minisystem/860/backplane_cpu.png

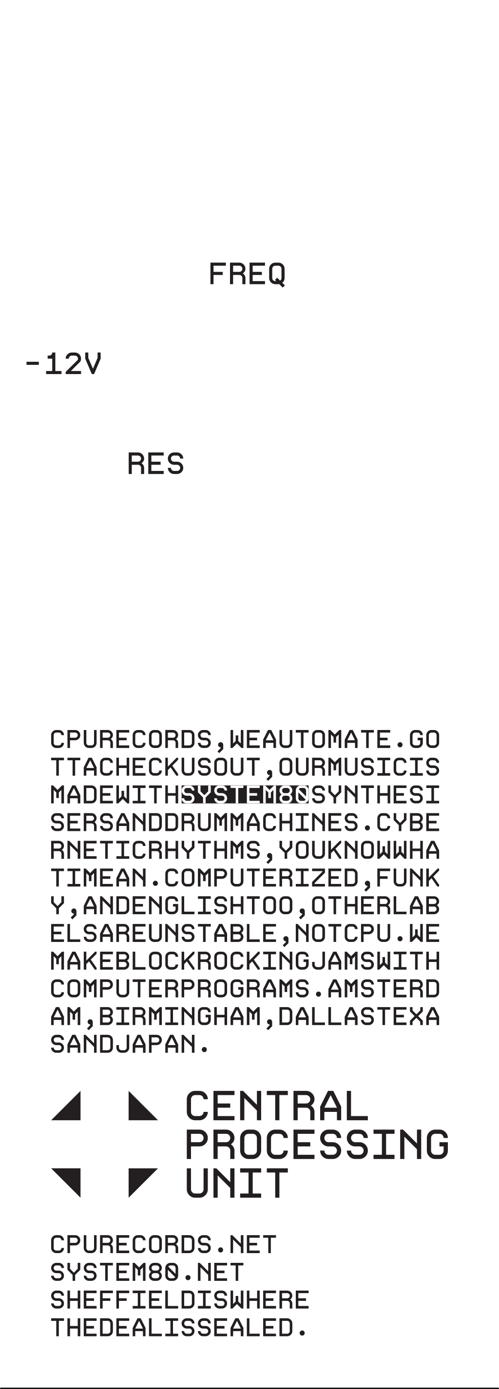
backplane_cpu.png
