minisystem/860/Gerbers/860-Eco1.User.dxf

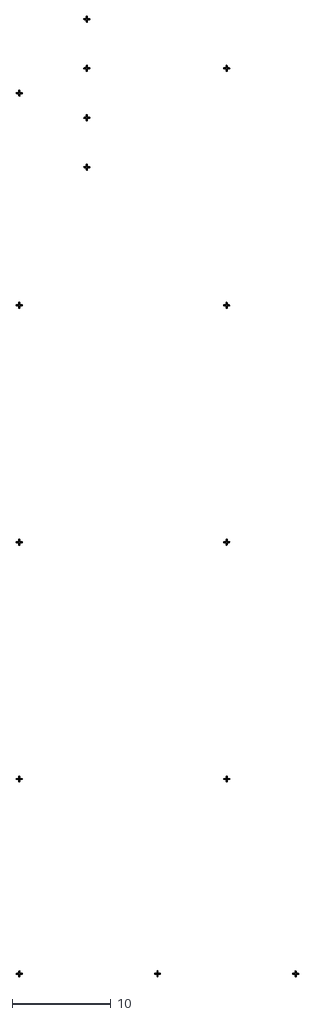
[picture p2: CAD file, 2019-05-11]
Gerbers/860-Eco1.User.dxf
28.6 x 97.3
