minisystem/860/Gerbers/860-F.SilkS.pdf

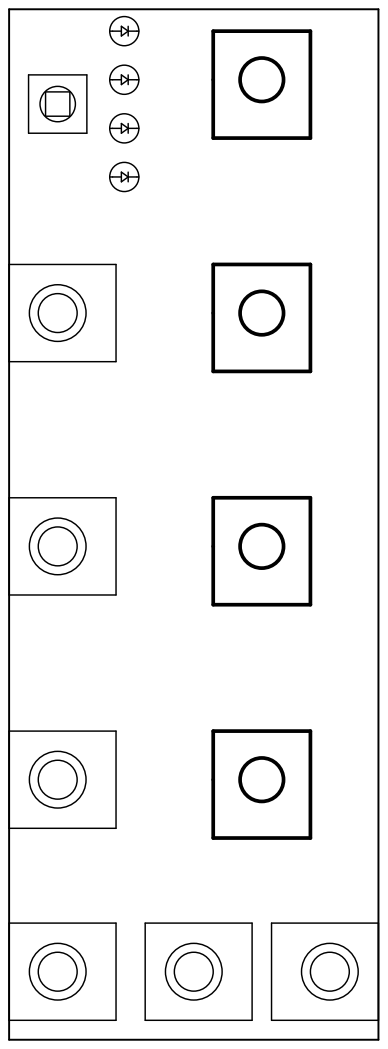
[picture p3: page 1]
