minisystem/860/Gerbers/860-Dwgs.User.pdf

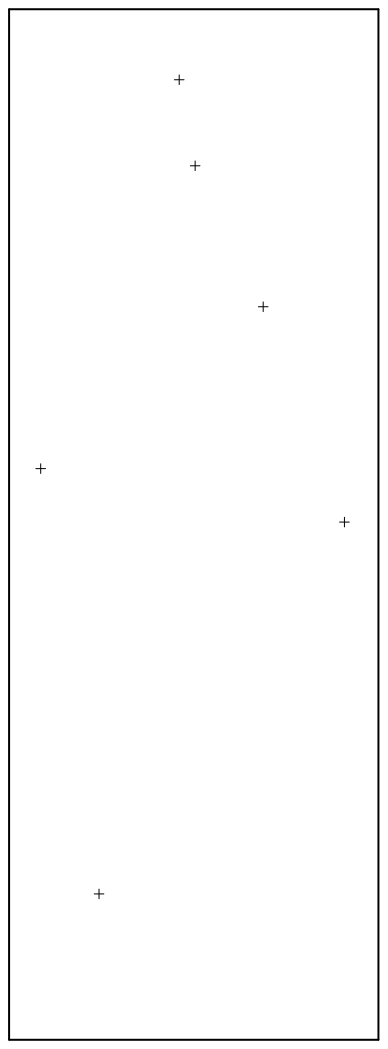
[picture p4: page 1]
