minisystem/860/Gerbers/860-Eco1.User.pdf

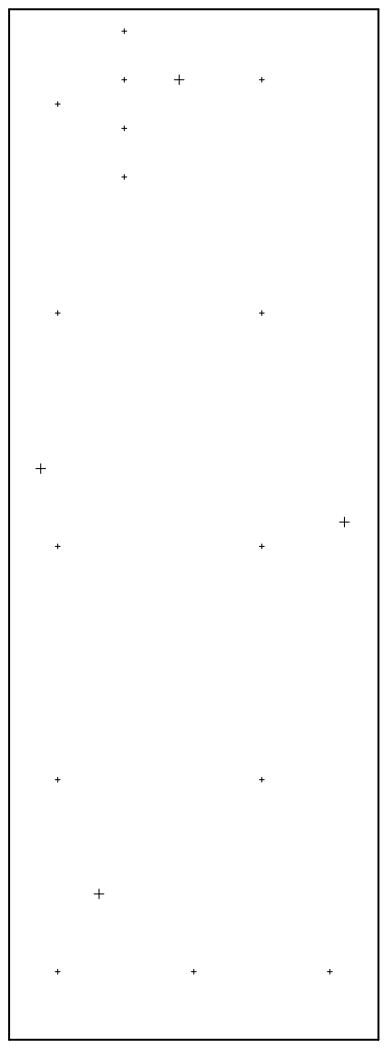
[picture p5: page 1]
