minisystem/860/Gerbers/Back_panel/860_backplane-Dwgs.User.pdf

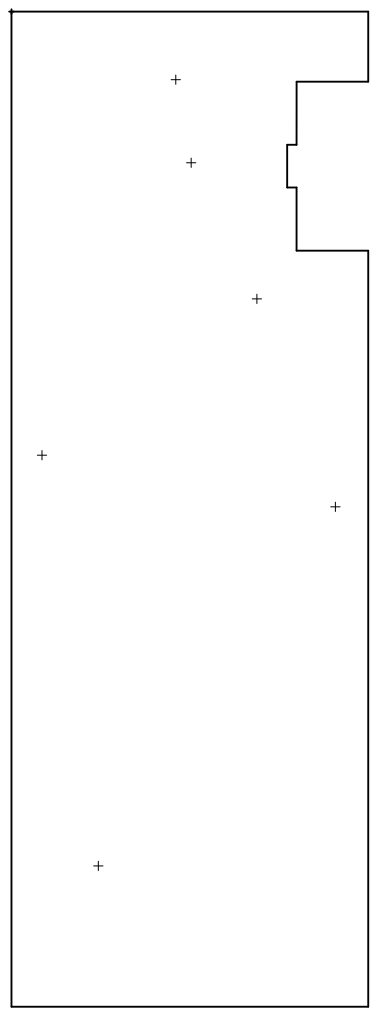
[picture p6: page 1]
