minisystem/860/860.kicad_pcb

## KiCad design 860.kicad_pcb (2019-06-26)

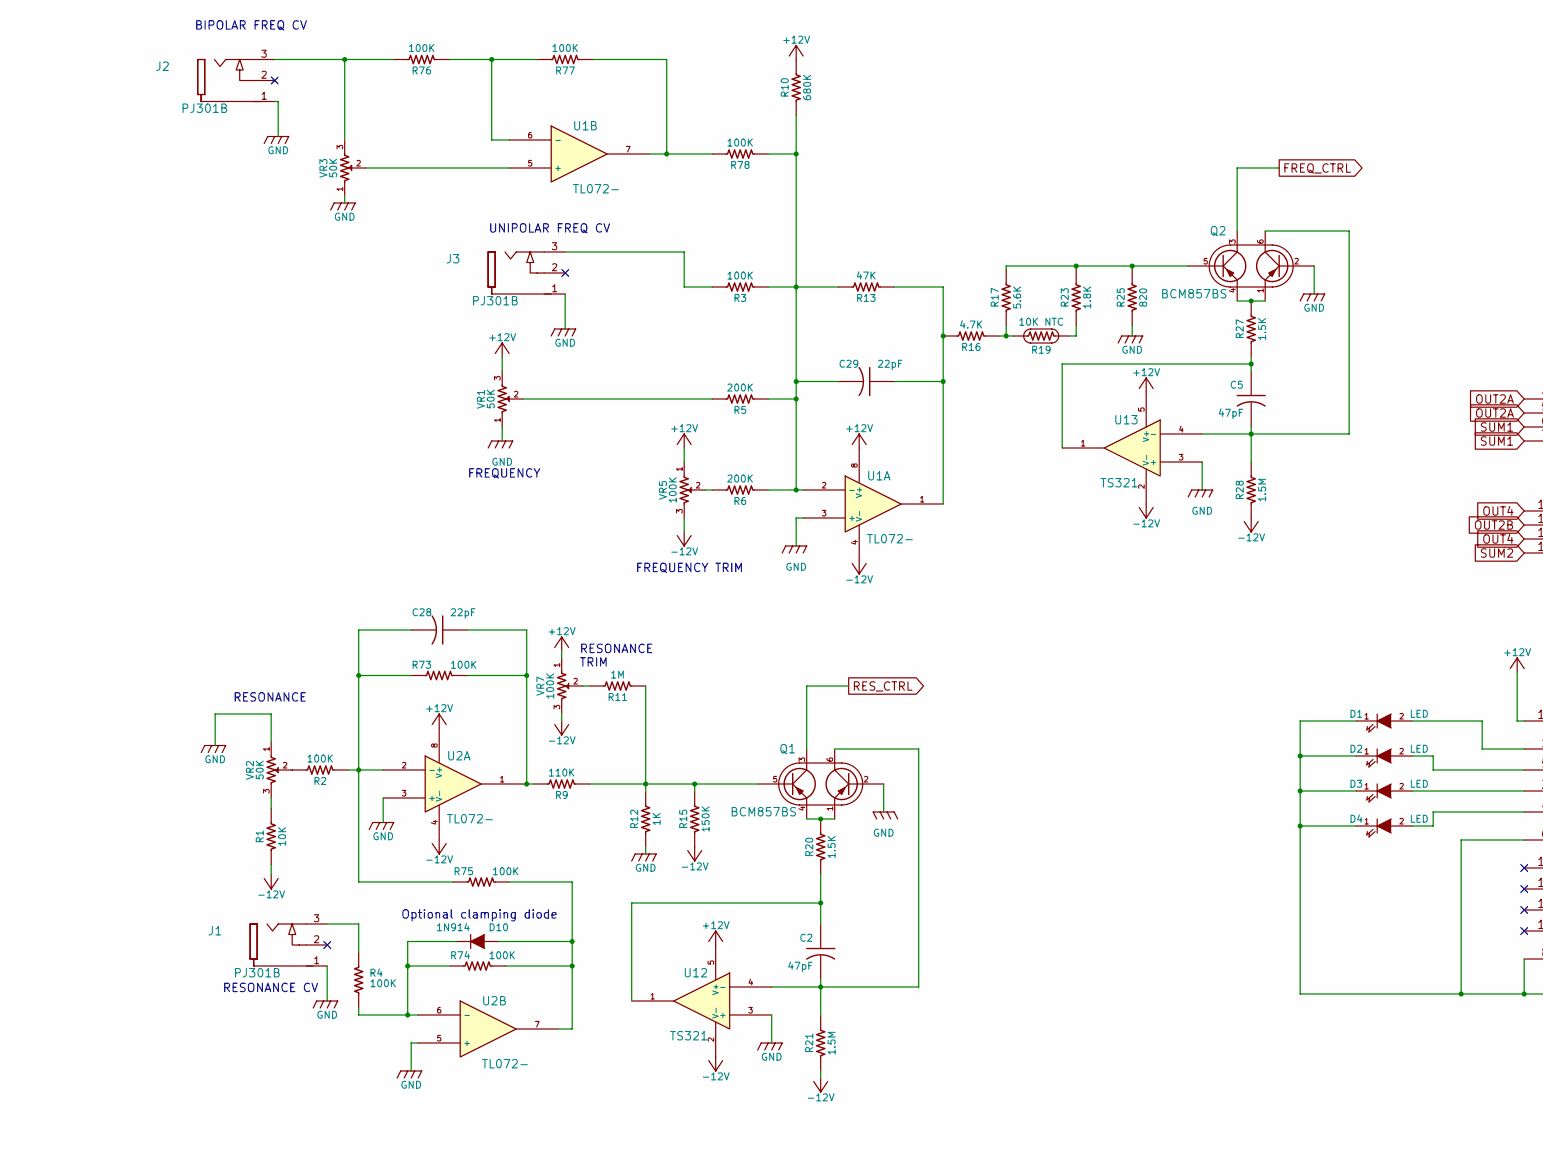
[picture p7: schematic 860.sch, part in row 1, column 1]

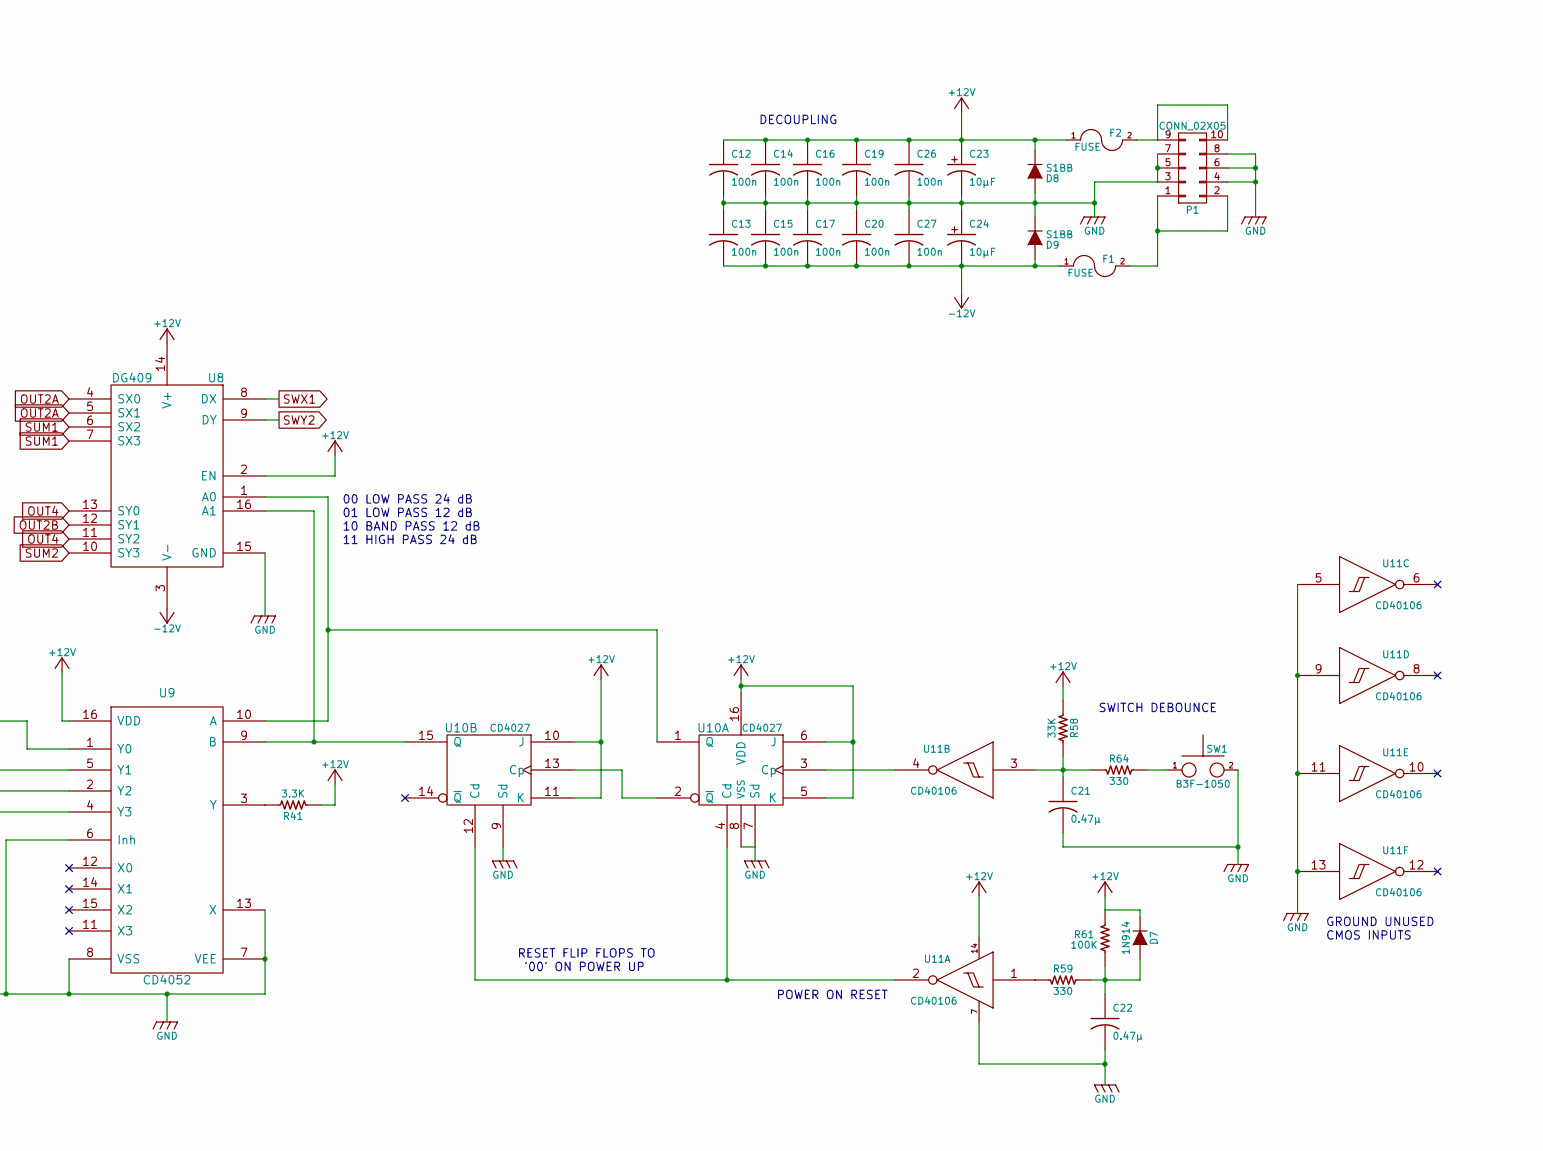
[picture p8: schematic 860.sch, part in row 1, column 2]

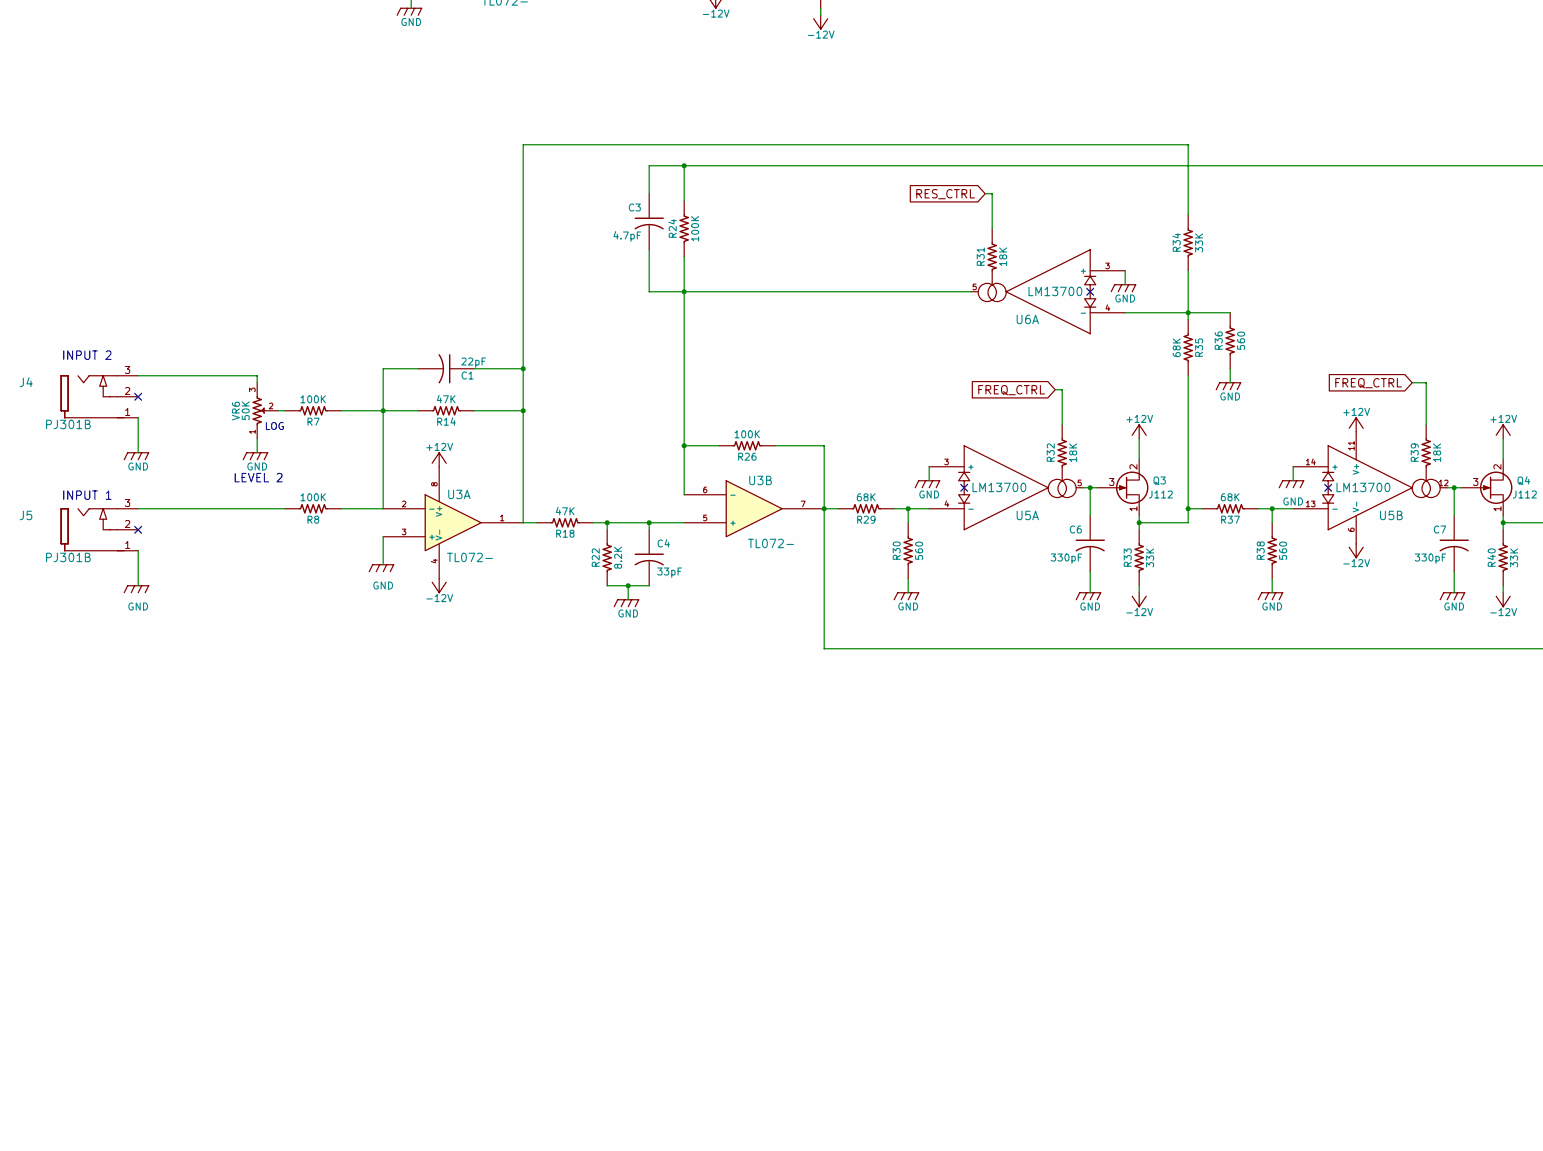
[picture p9: schematic 860.sch, part in row 2, column 1]

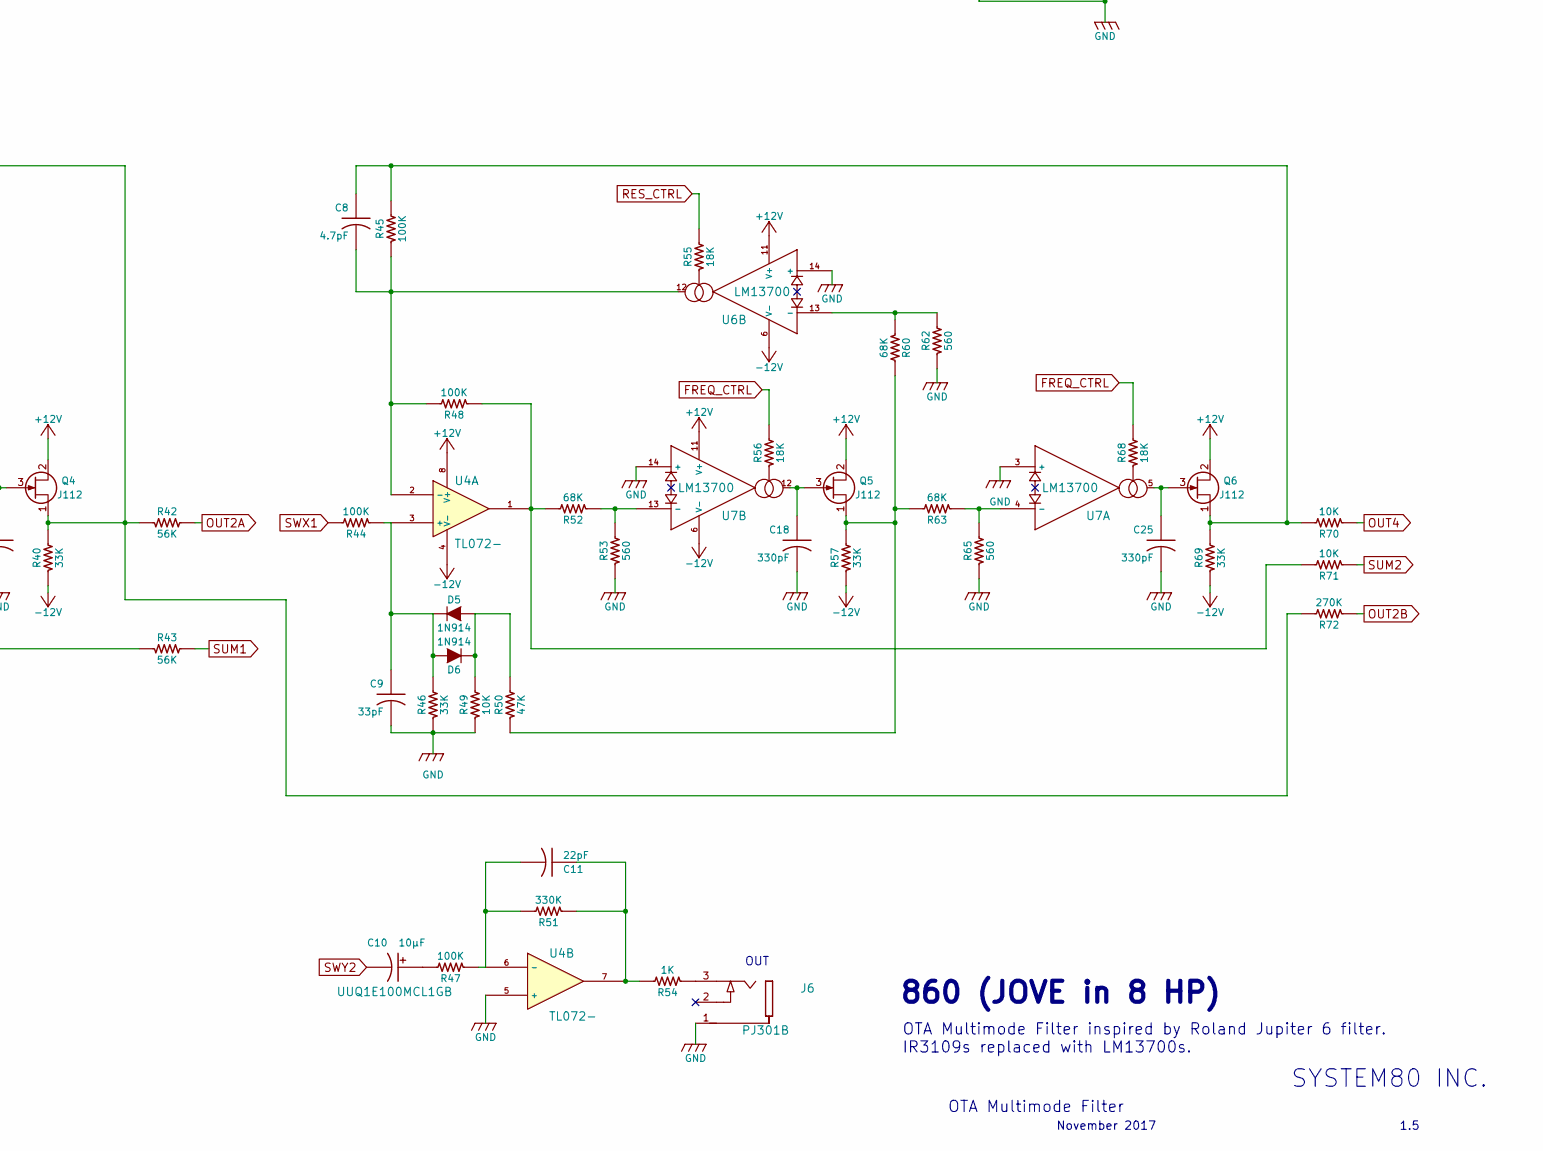
[picture p10: schematic 860.sch, part in row 2, column 2]

Parts:
C1, C11, C28, C29: 22pF; SM0603-C-JRL
C2, C5: 47pF; SM0603-C-JRL
C3, C8: 4.7pF; SM0603-C-JRL
C4, C9: 33pF; SM0603-C-JRL
C6, C7, C18, C25: 330pF; SM0805-HAND-C
C10: 10μF; jrl_c_elec_5x5.3; Part Number UUQ1E100MCL1GB
C12, C13, C14, C15, C16, C17, C19, C20, C26, C27: 100n; SM0603-C-JRL
C21, C22: 0.47μ; SM0603-C-JRL
C23, C24: 10μF; jrl_c_elec_5x5.3; Part Number UWJ1E100MCL1GB
D1, D2, D3, D4: LED; 3MM-LED-C1A2
D5, D6, D7, D10: 1N914; SOD323-C1A2
D8, D9: S1BB; SMB-1C2A
F1, F2: FUSE; SM0805-HAND
J1, J2, J3, J4, J5, J6: PJ301B; PJ-301B-JACK-SLOTS
P1: CONN_02X05; Pin_Header_Straight_2x05_Pitch2.54mm
Q1, Q2: BCM857BS; sot323-6
Q3, Q4, Q5, Q6: J112; SOT23-JRL
R1, R49, R70, R71: 10K; SM0603-R-JRL
R2, R3, R4, R7, R8, R24, R26, R44, R45, R47, R48, R61, R73, R74, R75, R76, R77, R78: 100K; SM0603-R-JRL
R5, R6: 200K; SM0603-R-JRL
R9: 110K; SM0603-R-JRL
R10: 680K; SM0603-R-JRL
R11: 1M; SM0603-R-JRL
R12, R54: 1K; SM0603-R-JRL
R13, R14, R18, R50: 47K; SM0603-R-JRL
R15: 150K; SM0603-R-JRL
R16: 4.7K; SM0603-R-JRL
R17: 5.6K; SM0603-R-JRL
R19: 10K NTC; SM0805-HAND
R20, R27: 1.5K; SM0603-R-JRL
R21, R28: 1.5M; SM0603-R-JRL
R22: 8.2K; SM0603-R-JRL
R23: 1.8K; SM0603-R-JRL
R25: 820; SM0603-R-JRL
R29, R35, R37, R52, R60, R63: 68K; SM0603-R-JRL
R30, R36, R38, R53, R62, R65: 560; SM0603-R-JRL
R31, R32, R39, R55, R56, R68: 18K; SM0603-R-JRL
R33, R34, R40, R46, R57, R58, R69: 33K; SM0603-R-JRL
R41: 3.3K; SM0603-R-JRL
R42, R43: 56K; SM0603-R-JRL
R51: 330K; SM0603-R-JRL
R59, R64: 330; SM0603-R-JRL
R72: 270K; SM0603-R-JRL
SW1: B3F-1050; B3F-1050-OMRON
U1, U2, U3, U4: TL072-; TSSOP8-JRL
U5, U6, U7: LM13700; SO16-JRL
U8: DG409; SO16-JRL
U9: CD4052; TSSOP-16_4.4x5mm_Pitch0.65mm
U10: CD4027; TSSOP-16_4.4x5mm_Pitch0.65mm
U11: CD40106; TSSOP-14_4.4x5mm_Pitch0.65mm
U12, U13: TS321; SOT-23-5
VR1, VR2, VR3: 50K; RD901F-ALPHA-POT-T18
VR5, VR7: 100K; TC33X-2
VR6: 50K; RV09AF-40-ALPHA-POT

Connections:
+12V: C12.1, C14.1, C16.1, C19.1, C23.1 (+), C26.1, D7.1 (K), D8.1 (K), F2.1, Q3.2 (D), Q4.2 (D), Q5.2 (D), Q6.2 (D), R10.2, R41.1, R58.2, R61.2, U1.8 (V+), U2.8 (V+), U3.8 (V+), U4.8 (V+), U5.11 (V+), U6.11 (V+), U7.11 (V+), U8.2 (EN), U8.14 (V+), U9.16 (VDD), U10.5 (K), U10.6 (J), U10.10 (J), U10.11 (K), U10.16 (VDD), U11.14 (VDD), U12.5 (V+), U13.5 (V+), VR1.3, VR5.1, VR7.1
-12V: C13.2, C15.2, C17.2, C20.2, C24.2 (-), C27.2, D9.2 (A), F1.1, R1.2, R15.2, R21.2, R28.2, R33.1, R40.1, R57.1, R69.1, U1.4 (V-), U2.4 (V-), U3.4 (V-), U4.4 (V-), U5.6 (V-), U6.6 (V-), U7.6 (V-), U8.3 (V-), U12.2 (V-), U13.2 (V-), VR5.3, VR7.3
FREQ_CTRL: Q2.3 (C2), R32.2, R39.2, R56.2, R68.2
GND: C4.2, C6.2, C7.2, C9.2, C12.2, C13.1, C14.2, C15.1, C16.2, C17.1, C18.2, C19.2, C20.1, C21.2, C22.2, C23.2 (-), C24.1 (+), C25.2, C26.2, C27.1, D1.1 (K), D2.1 (K), D3.1 (K), D4.1 (K), D8.2 (A), D9.1 (K), J1.1, J2.1, J3.1, J4.1, J5.1, J6.1, P1.3, P1.4, P1.5, P1.6, P1.7, P1.8, Q1.2 (B1), Q2.2 (B1), R12.2, R22.1, R25.1, R30.1, R36.1, R38.1, R46.1, R49.1, R53.1, R62.1, R65.1, SW1.2, U1.3 (+), U2.3 (+), U2.5 (+), U3.3 (+), U4.5 (+), U5.3 (+), U5.14 (+), U6.3 (+), U6.14 (+), U7.3 (+), U7.14 (+), U8.15 (GND), U9.6 (Inh), U9.7 (VEE), U9.8 (VSS), U9.13 (X), U10.7 (Sd), U10.8 (VSS), U10.9 (Sd), U11.5 (In), U11.7 (VSS), U11.9 (In), U11.11 (In), U11.13 (In), U12.3 (+), U13.3 (+), VR1.1, VR2.1, VR3.1, VR6.1
unnamed: C1.1, R14.1, R18.2, R34.2, U3.1
unnamed: C1.2, R7.1, R8.1, R14.2, U3.2 (-)
unnamed: C2.1, R20.2, U12.1
unnamed: C2.2, Q1.6 (C1), R21.1, U12.4 (-)
unnamed: C3.1, Q4.1 (S), R24.2, R40.2, R42.2, R72.2
unnamed: C3.2, R24.1, R26.2, U3.6 (-), U6.5
unnamed: C4.1, R18.1, R22.2, U3.5 (+)
unnamed: C5.1, R27.2, U13.1
unnamed: C5.2, Q2.6 (C1), R28.1, U13.4 (-)
unnamed: C6.1, Q3.3 (G), U5.5
unnamed: C7.1, Q4.3 (G), U5.12
unnamed: C8.1, Q6.1 (S), R45.2, R69.2, R70.2
unnamed: C8.2, R45.1, R48.2, U4.2 (-), U6.12
unnamed: C9.1, D5.1 (K), D6.2 (A), R44.1, R46.2, U4.3 (+)
unnamed: C10.1 (+), R47.2
unnamed: C11.1, R51.1, R54.2, U4.7
unnamed: C11.2, R47.1, R51.2, U4.6 (-)
unnamed: C18.1, Q5.3 (G), U7.12
unnamed: C21.1, R58.1, R64.1, U11.3 (In)
unnamed: C22.1, D7.2 (A), R59.2, R61.1
unnamed: C25.1, Q6.3 (G), U7.5
unnamed: C28.1, R9.2, R73.1, U2.1
unnamed: C28.2, R2.1, R73.2, R75.2, U2.2 (-)
unnamed: C29.1, R13.1, R16.2, U1.1
unnamed: C29.2, R3.1, R5.1, R6.1, R10.1, R13.2, R78.1, U1.2 (-)
unnamed: D1.2 (A), U9.1 (Y0)
unnamed: D2.2 (A), U9.5 (Y1)
unnamed: D3.2 (A), U9.2 (Y2)
unnamed: D4.2 (A), U9.4 (Y3)
unnamed: D5.2 (A), D6.1 (K), R49.2, R50.2
unnamed: D10.1 (K), R4.1, R74.2, U2.6 (-)
unnamed: D10.2 (A), R74.1, R75.1, U2.7
unnamed: F1.2, P1.1, P1.2
unnamed: F2.2, P1.9, P1.10
unnamed: J1.3, R4.2
unnamed: J2.3, R76.2, VR3.3
unnamed: J3.3, R3.2
unnamed: J4.3, VR6.3
unnamed: J5.3, R8.2
unnamed: J6.3, R54.1
unnamed: Q1.1 (E1), Q1.4 (E2), R20.1
unnamed: Q1.5 (B2), R9.1, R11.1, R12.1, R15.1
unnamed: Q2.1 (E1), Q2.4 (E2), R27.1
unnamed: Q2.5 (B2), R17.2, R23.2, R25.2
unnamed: Q3.1 (S), R33.2, R35.2, R37.2
unnamed: Q5.1 (S), R50.1, R57.2, R60.2, R63.2
unnamed: R1.1, VR2.3
unnamed: R2.2, VR2.2
unnamed: R5.2, VR1.2
unnamed: R6.2, VR5.2
unnamed: R7.2, VR6.2
unnamed: R11.2, VR7.2
unnamed: R16.1, R17.1, R19.2
unnamed: R19.1, R23.1
unnamed: R26.1, R29.2, R43.2, U3.7
unnamed: R29.1, R30.2, U5.4 (-)
unnamed: R31.1, U6.1
unnamed: R32.1, U5.1
unnamed: R34.1, R35.1, R36.2, U6.4 (-)
unnamed: R37.1, R38.2, U5.13 (-)
unnamed: R39.1, U5.16
unnamed: R41.2, U9.3 (Y)
unnamed: R48.1, R52.2, R71.2, U4.1
unnamed: R52.1, R53.2, U7.13 (-)
unnamed: R55.1, U6.16
unnamed: R56.1, U7.16
unnamed: R59.1, U11.1 (In)
unnamed: R60.1, R62.2, U6.13 (-)
unnamed: R63.1, R65.2, U7.4 (-)
unnamed: R64.2, SW1.1
unnamed: R68.1, U7.1
unnamed: R76.1, R77.2, U1.6 (-)
unnamed: R77.1, R78.2, U1.7
unnamed: U1.5 (+), VR3.2
unnamed: U8.1 (A0), U9.10 (A), U10.1 (Q)
unnamed: U10.3 (Cp), U11.4 (Out)
unnamed: U10.4 (Cd), U10.12 (Cd), U11.2 (Out)
unnamed: U10.2 (~Q), U10.13 (Cp)
unnamed: U8.16 (A1), U9.9 (B), U10.15 (Q)
OUT2A: R42.1, U8.4 (SX0), U8.5 (SX1)
OUT2B: R72.1, U8.12 (SY1)
OUT4: R70.1, U8.11 (SY2), U8.13 (SY0)
RES_CTRL: Q1.3 (C2), R31.2, R55.2
SUM1: R43.1, U8.6 (SX2), U8.7 (SX3)
SUM2: R71.1, U8.10 (SY3)
SWX1: R44.2, U8.8 (DX)
SWY2: C10.2 (-), U8.9 (DY)

Notes on the sheet:
00 LOW PASS 24 dB 01 LOW PASS 12 dB 10 BAND PASS 12 dB 11 HIGH PASS 24 dB
POWER ON RESET
SWITCH DEBOUNCE
DECOUPLING
GROUND UNUSED CMOS INPUTS
RESET FLIP FLOPS TO '00' ON POWER UP
LOG
FREQUENCY TRIM
FREQUENCY
RESONANCE
BIPOLAR FREQ CV
RESONANCE CV
RESONANCE TRIM
UNIPOLAR FREQ CV
Optional clamping diode
INPUT 2
LEVEL 2
INPUT 1
OTA Multimode Filter
1.5
OUT
November 2017
OTA Multimode Filter inspired by Roland Jupiter 6 filter. IR3109s replaced with LM13700s.
860 (JOVE in 8 HP)
SYSTEM80 INC.

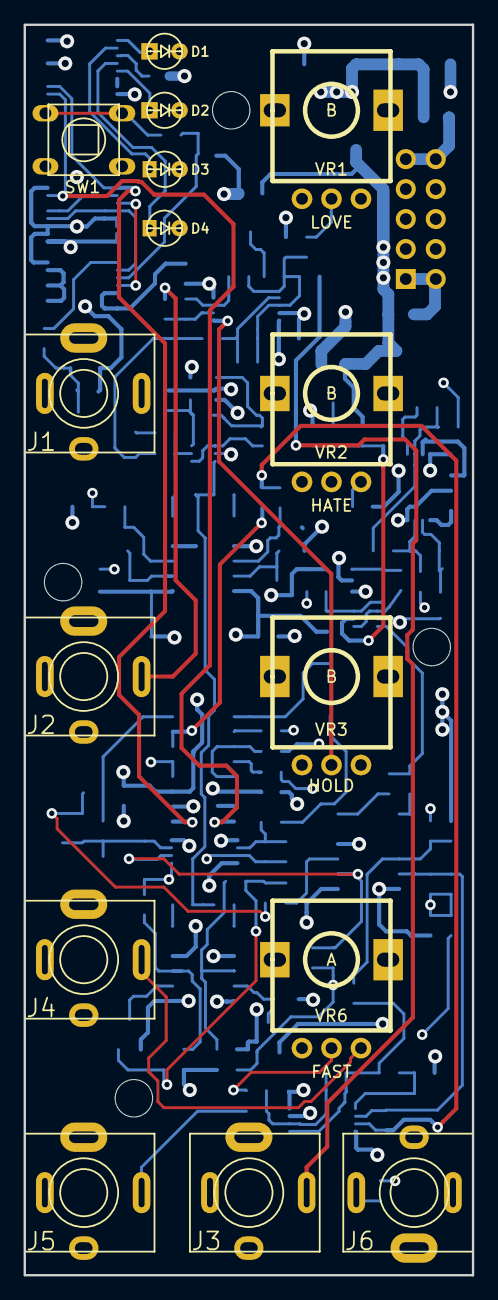
[picture p11: board 860.kicad_pcb from above]

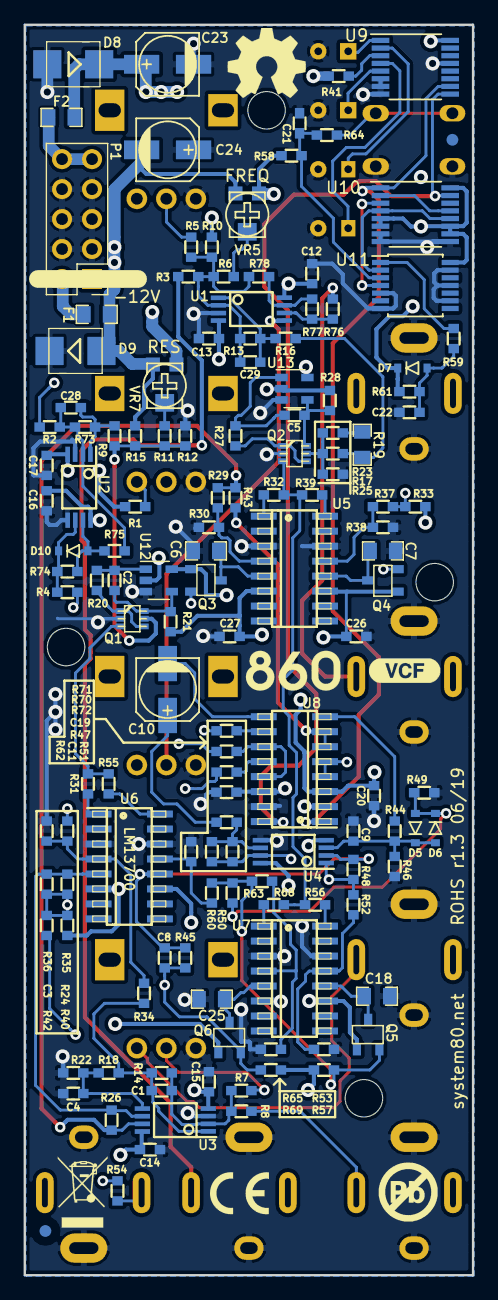
[picture p12: board 860.kicad_pcb from below]

Board: 4 copper layers, 38.0 x 106.0 mm, 154 parts (135 on the bottom side), 91 nets.

Other parts of the board:
SNAP-HOLE-0.125-INCH, SNAP-HOLE-0.125-INCH#2, SNAP-HOLE-0.125-INCH#3, SNAP-HOLE-0.125-INCH#4: VAL**; SNAP_HOLE_0.125_INCH
