minisystem/860/(commit log)

2017-11-26 routed, silk screen adjusted
    [860.kicad_pcb, 860.sch]
2017-11-26 getting pretty close to done
    [860.kicad_pcb]
2018-02-08 front component adjustments to jive with panel template
    [860.kicad_pcb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]
2018-02-09 tweaked routing to improve ground plane
    [860.kicad_pcb]
2019-05-10 fixed hardware placement to match panel mechanical, moving power header
    [860.kicad_pcb]
2019-05-11 updated 0603 footprints for production, new hole centres for aligning with panel holes
    [860-Eco1.User.dxf, 860.kicad_pcb]
2019-06-04 added backplane and corresponding snap holes
    [860.kicad_pcb, 860_backplane.kicad_pcb]
2019-06-05 working on backplane, DRC done on 860 PCB
    [860.kicad_pcb, 860_backplane.kicad_pcb]
2019-06-08 silk screen adjust on 860 PCB, alignment check of backplane: OK
    [860.kicad_pcb, 860_backplane.kicad_pcb]
2019-06-08 alignment to front panel sample: OK
    [860.kicad_pcb]
2019-06-12 ordered next revision PCB for testing, fitting, added backplane
    [860-B.Cu.gbl, 860-B.Mask.gbs, 860-B.SilkS.gbo, 860-Edge.Cuts.gm1, 860-F.Cu.gtl, 860-F.Mask.gts, 860-F.SilkS.gto, 860.drl]
2019-06-25 silk screen fiddling before panelization
    [860.kicad_pcb]
2019-08-24 updating user guide, fabrication outputs for pick and place
    [860.csv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]
